simonyuen1999/SportTimer/7-segment-display.webp

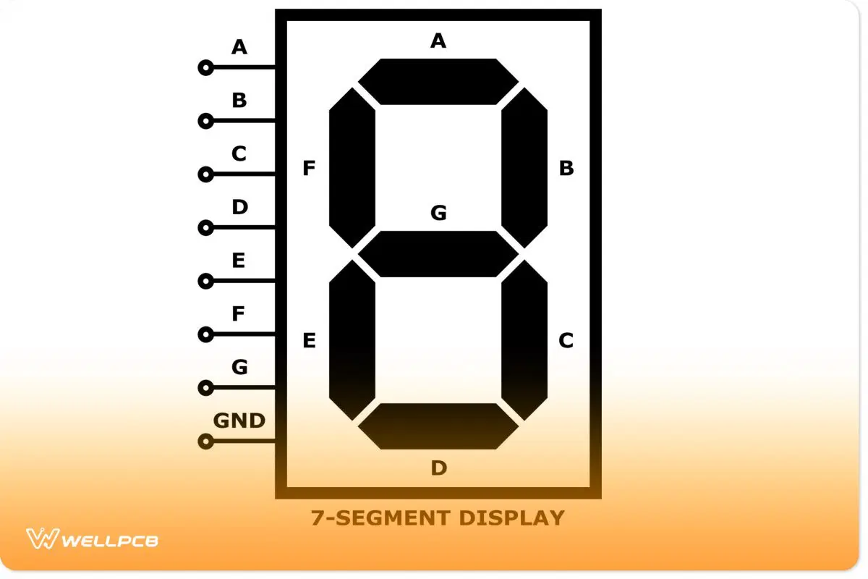
7-segment-display.webp
