simonyuen1999/SportTimer/7Segment.jpg

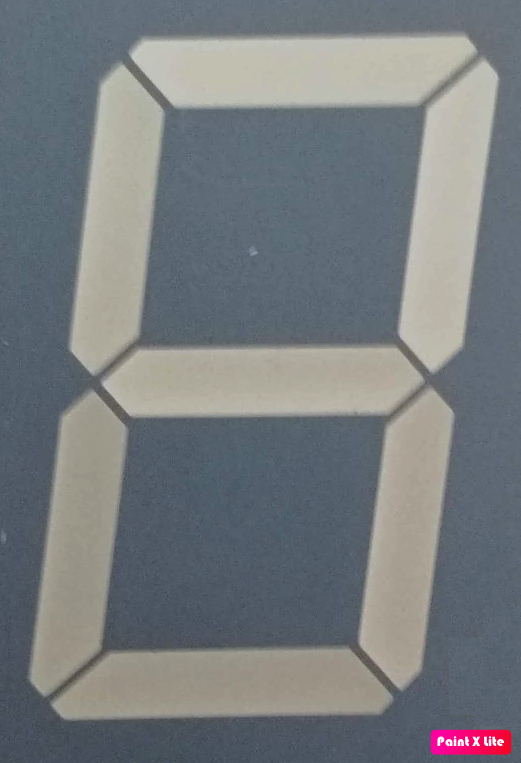
7Segment.jpg
