simonyuen1999/SportTimer/jclpcb/out/bottom_silk_check.png

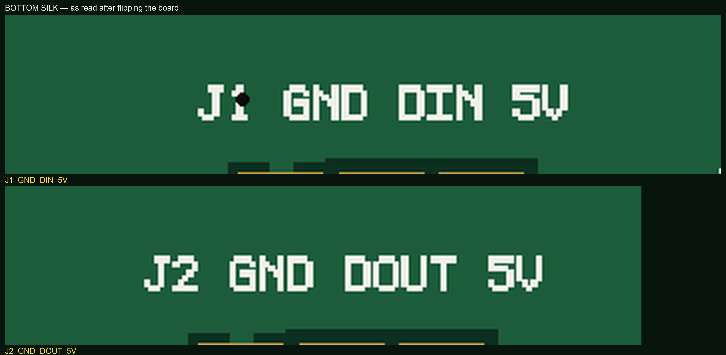
jclpcb/out/bottom_silk_check.png
