simonyuen1999/SportTimer/jclpcb/out/c10_back_annotated.png

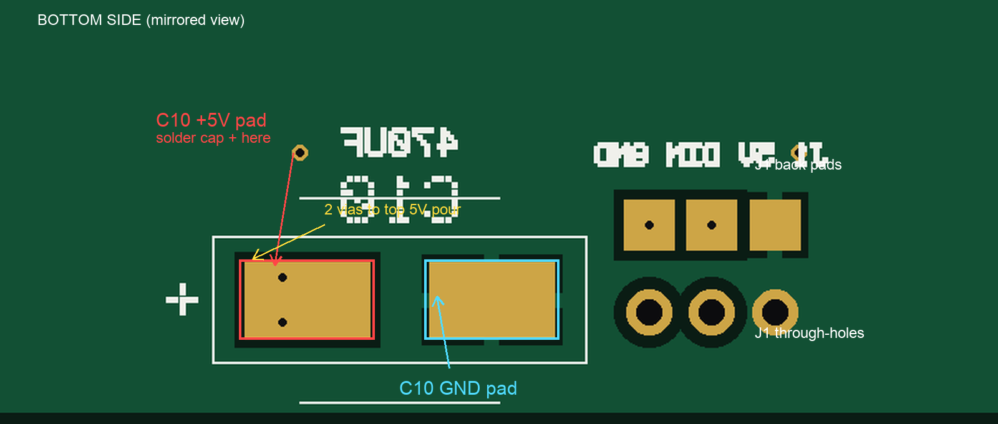
jclpcb/out/c10_back_annotated.png
