simonyuen1999/SportTimer/jclpcb/out/c10_zoom.png

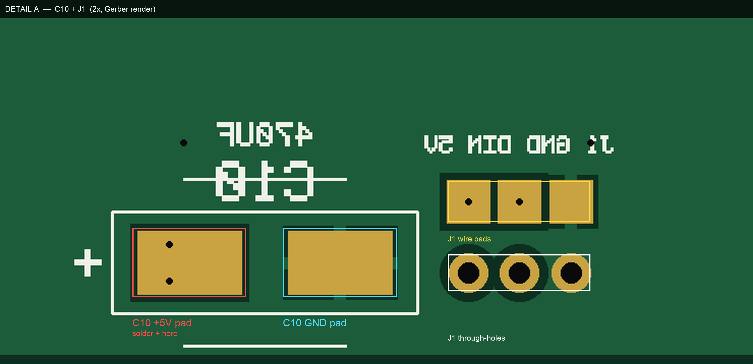
jclpcb/out/c10_zoom.png
