simonyuen1999/SportTimer/jclpcb/out/segments_cut_dimensions.png

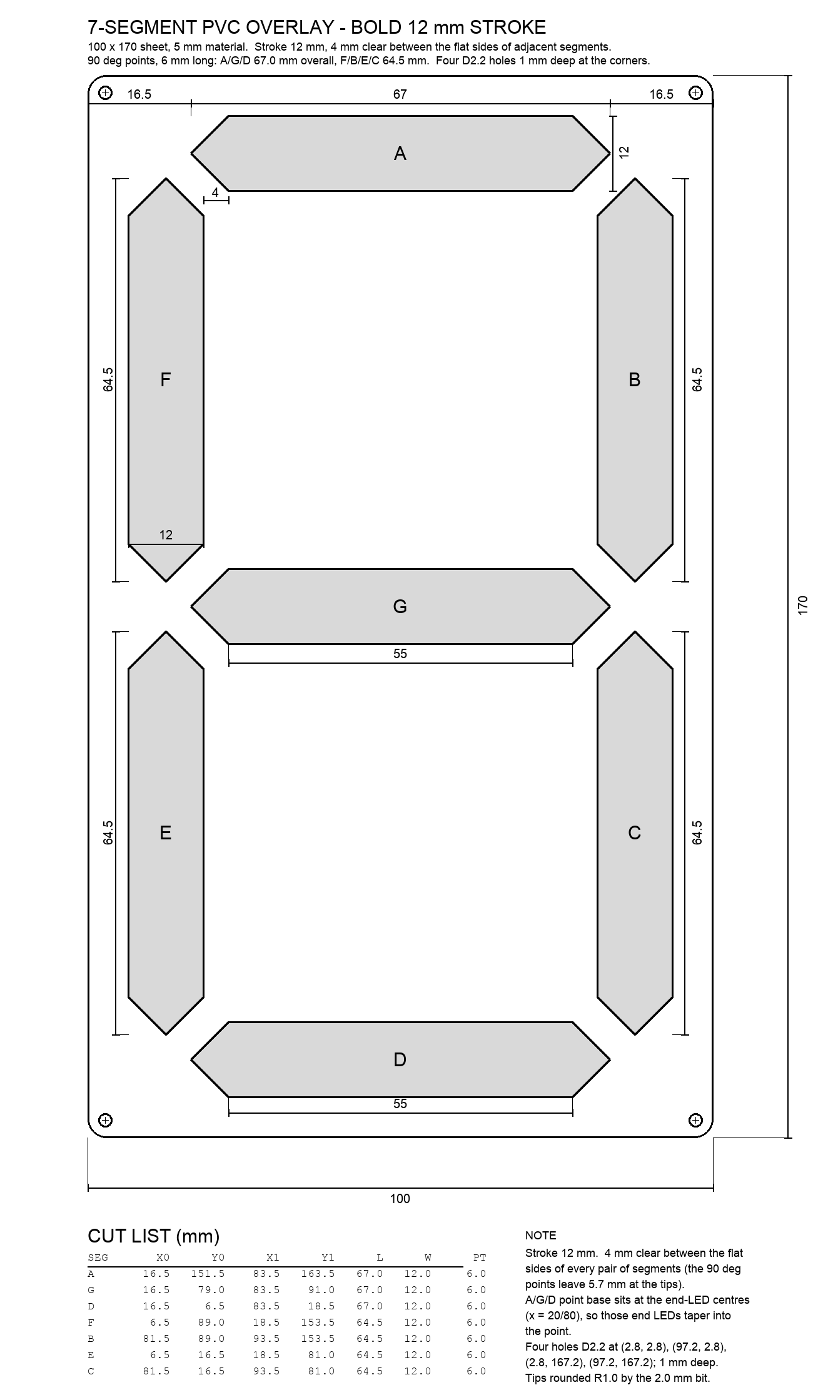
jclpcb/out/segments_cut_dimensions.png
