simonyuen1999/SportTimer/jclpcb/out/zoom_c10.png

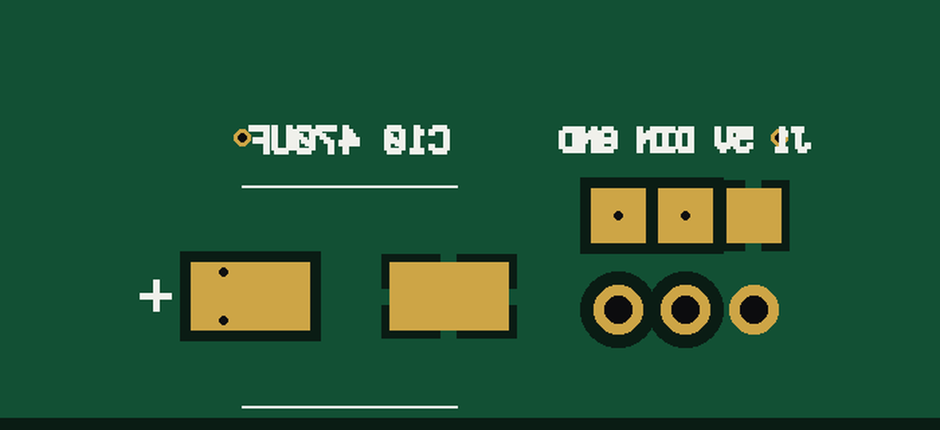
jclpcb/out/zoom_c10.png
