simonyuen1999/SportTimer/jclpcb/out/zoom_c10_now.png

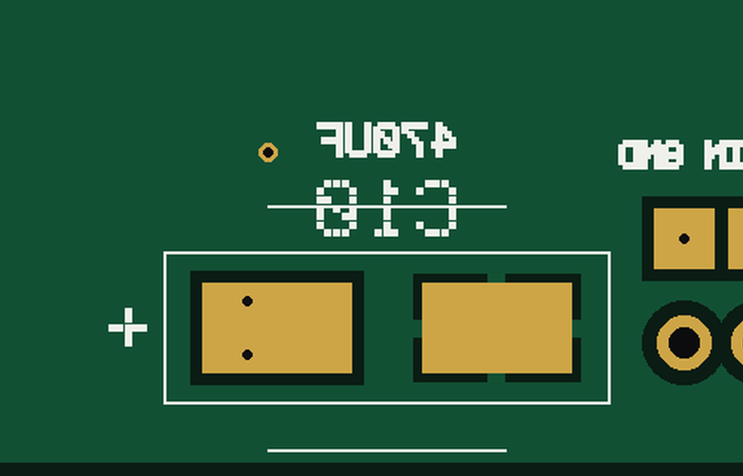
jclpcb/out/zoom_c10_now.png
