simonyuen1999/SportTimer/jclpcb/out/BOM_JLCPCB.csv

Comment | Designator | Footprint | LCSC Part #
WS2812B | B3,B2,B1,C3,C2,C1,D4,D3,D2,D1,E3,E2,E1,F3,F2,F1,A1,A2,A3,A4,G4,G3,G2,G1 | LED5050_WS2812B | C2761795
