simonyuen1999/SportTimer/jclpcb/out/segment_mask.dxf

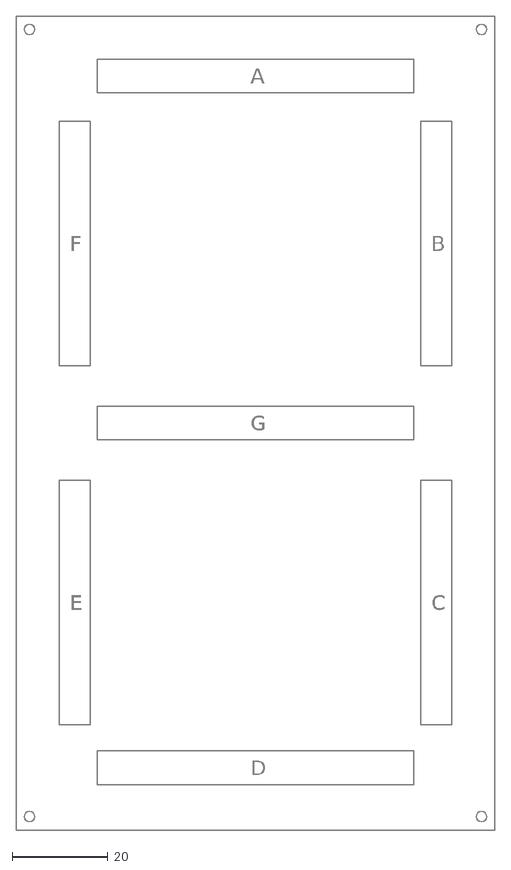
[picture p11: CAD file, 2026-10-22]
jclpcb/out/segment_mask.dxf
A
G
D
F
B
E
C
