simonyuen1999/SportTimer/(commit log)

2026-08-30 Add passdepth, board-thickness, and cutting-paths into Make4SegementXXX.py programs
2026-08-30 Add show-board-dim parameter into both Make4SegementXXX.py programs
2026-08-31 Fix all before CNC cut
2026-09-01 Add profile function in Make7Segement.py
    [profile.cfg]
2026-09-01 Implement new wooden.cfg profile
    [wooden.cfg]
2026-09-01 Fix --show-board-dim with profile function
2026-09-01 Add remove the middle of segment material function
    [thick_board.cfg, thin_board.cfg]
2026-09-02 Cut the thin board and fix the issue along
    [thin_board.cfg]
2026-09-02 Fix for cutting thick wooden and PVC
    [thick_PVC.cfg, thick_wooden.cfg]
2026-09-02 donw thick_wooden.cfg cutting
    [thick_wooden.cfg]
2026-09-07 Completed the test withh PVC and Wood with 3.175 bit
    [thick_PVC.cfg, thick_wooden.cfg]
2026-09-09 Change Alter_PVC configuration
    [Alter_PVC.cfg]
2026-09-09 Tested Segment generation and pocket-middle true case
2026-09-09 Finished Make7Alter.py testing and added generate 2 digit cutting path option
    [Alter_PVC.cfg]
2026-09-09 Finish 2 digit in Make7Alter.py program
    [Alter_PVC.cfg]
2026-09-10 Begin 9mm PVC cutting
    [Alter_PVC.cfg]
2026-09-30 Getting code.py from pico which has the top 7 LED code
2026-10-10 Re-organize old Arduino project into this repo, add the later big soccer timer code
2026-10-10 Checkin the digit_ws2812.ino from /Volumes/Backup/Arduino/Arduino_2025/digit_ws2812
2026-10-10 reduce delay to smaller value. Fix Beep during timer pop. Change to non-blocking beep.
    [digit_ws2812.ino]
2026-10-10 Fix last 20 second code, before add beep in last 20 second
    [digit_ws2812.ino]
2026-10-10 20261010: Fix zero beep, inc loop freq, last 20 seconds display and 0:00 color mode
    [digit_ws2812.ino]
2026-10-12 Fix PLUS & MINUS issues, Reset and Restart, initial maxMinutes, 0:00 for Timer Expired
2026-10-22 Add PCB board design for JCLPCB manufactory
